aknepper/aknepper_clock/HPS_Round_Clock/HPS_Round_Clock.kicad_pcb

## KiCad design HPS_Round_Clock/HPS_Round_Clock.kicad_pcb (2022-07-21)

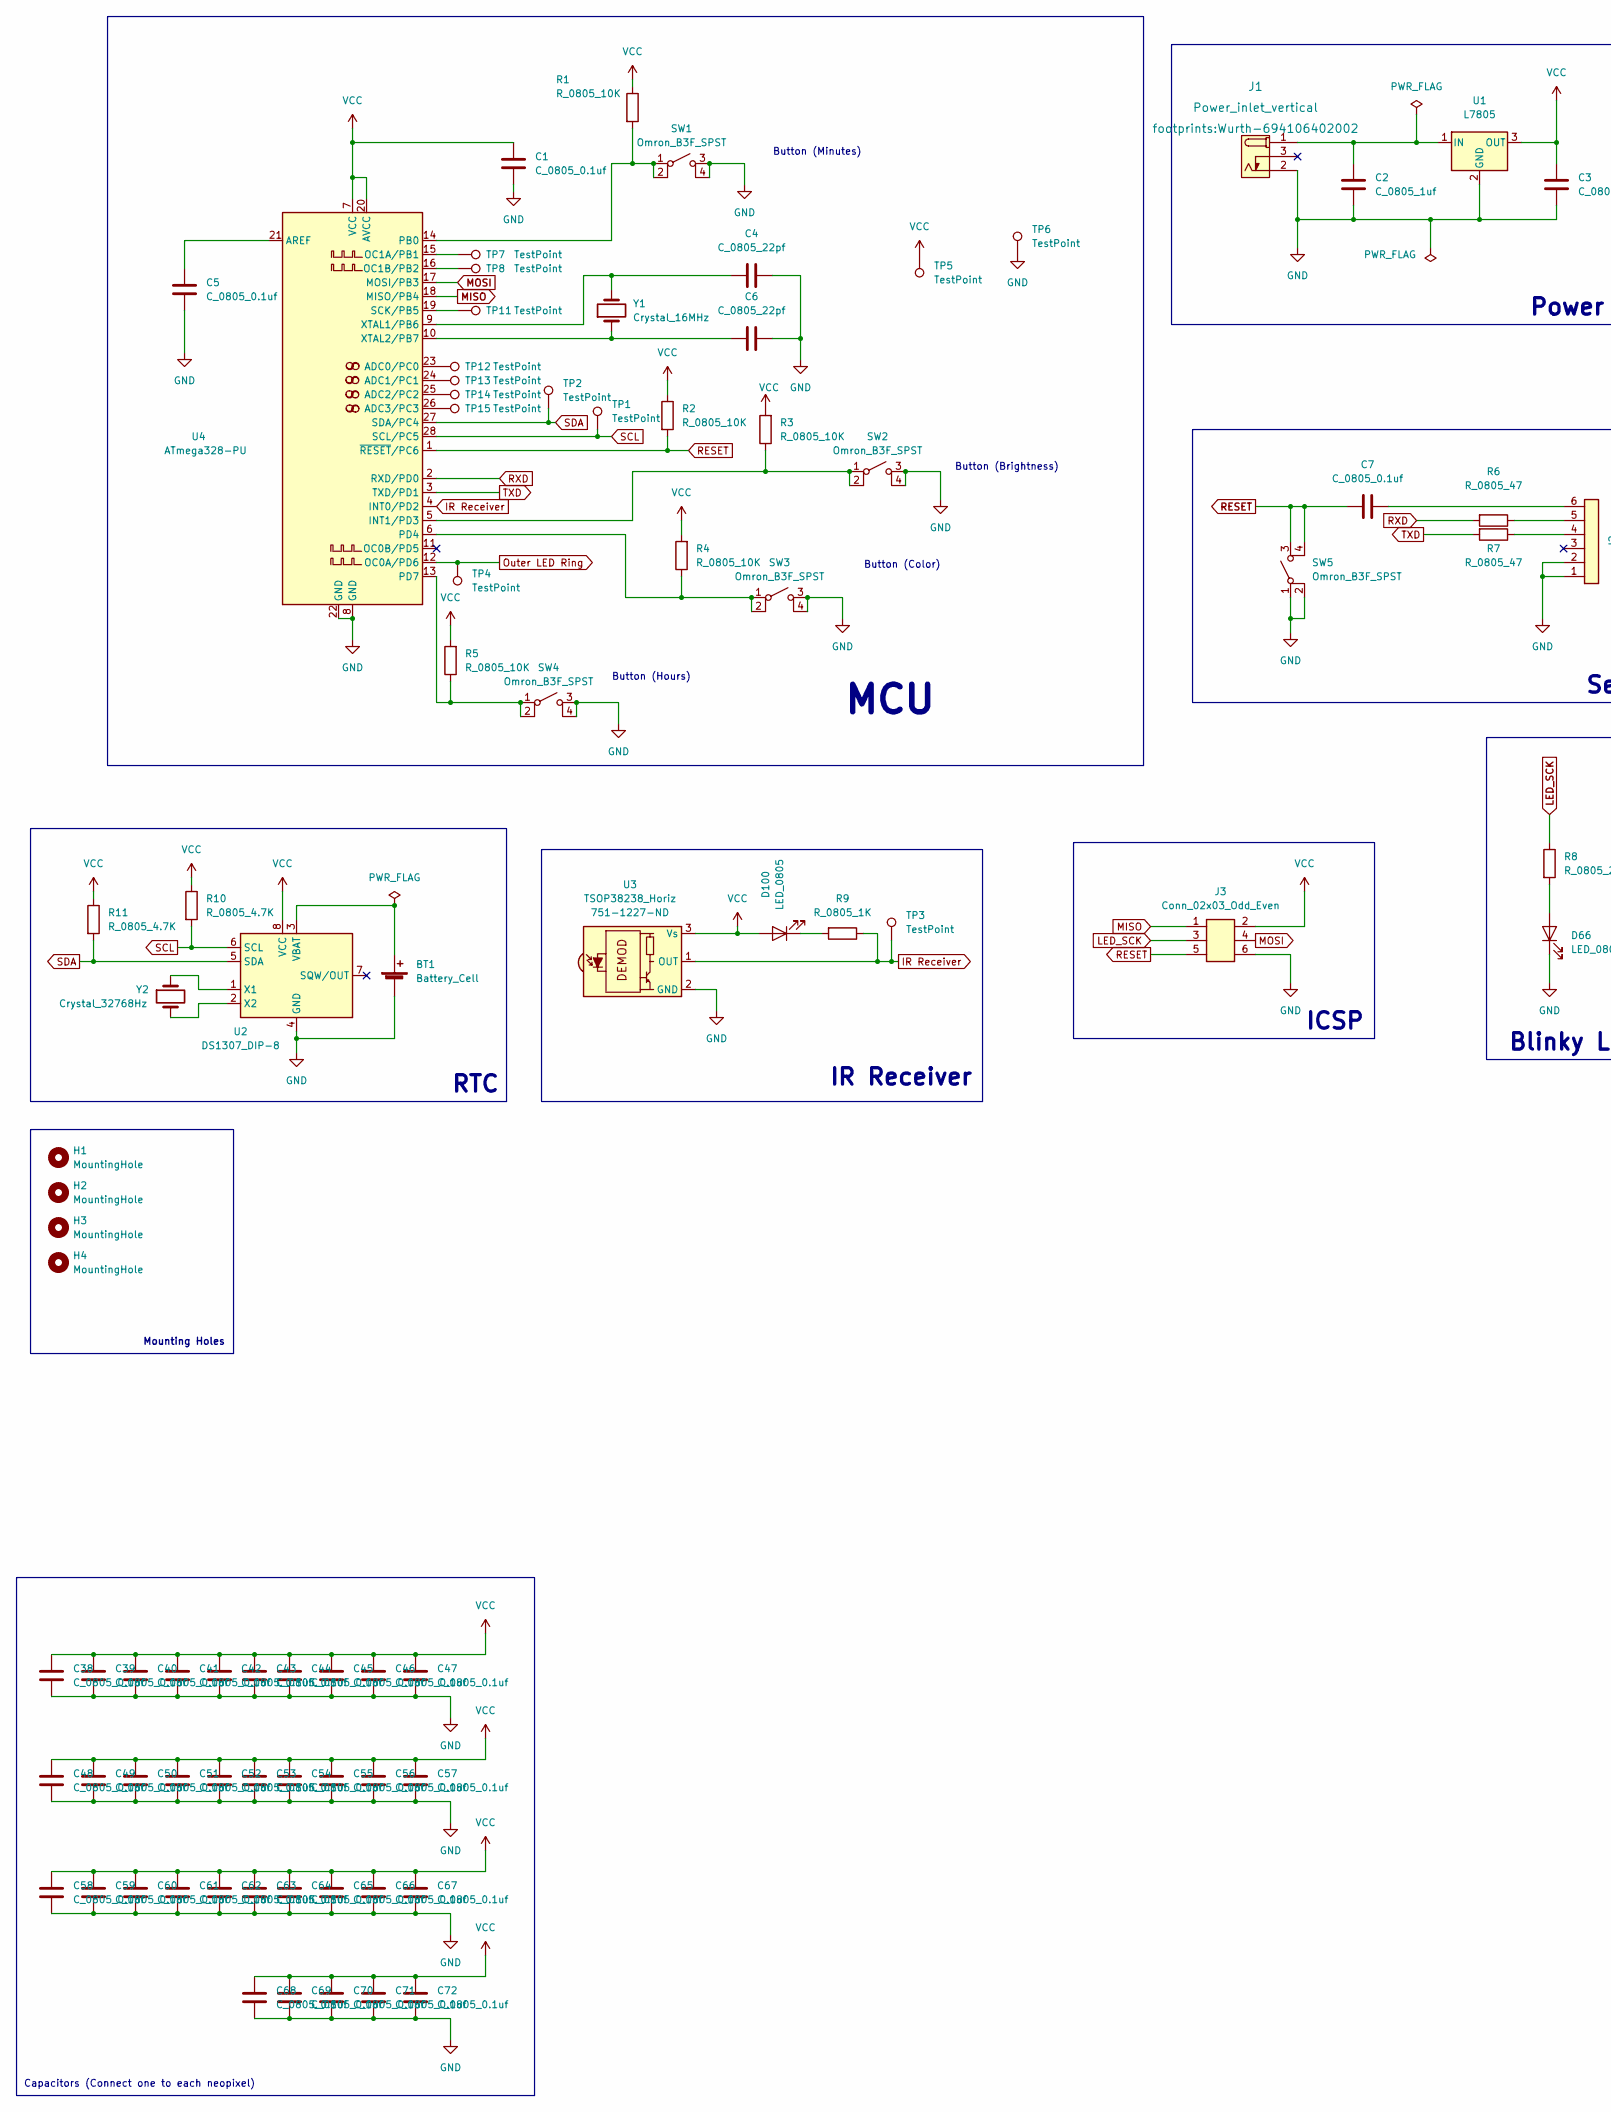
[picture p1: schematic HPS_Round_Clock.kicad_sch, part in row 1, column 1]

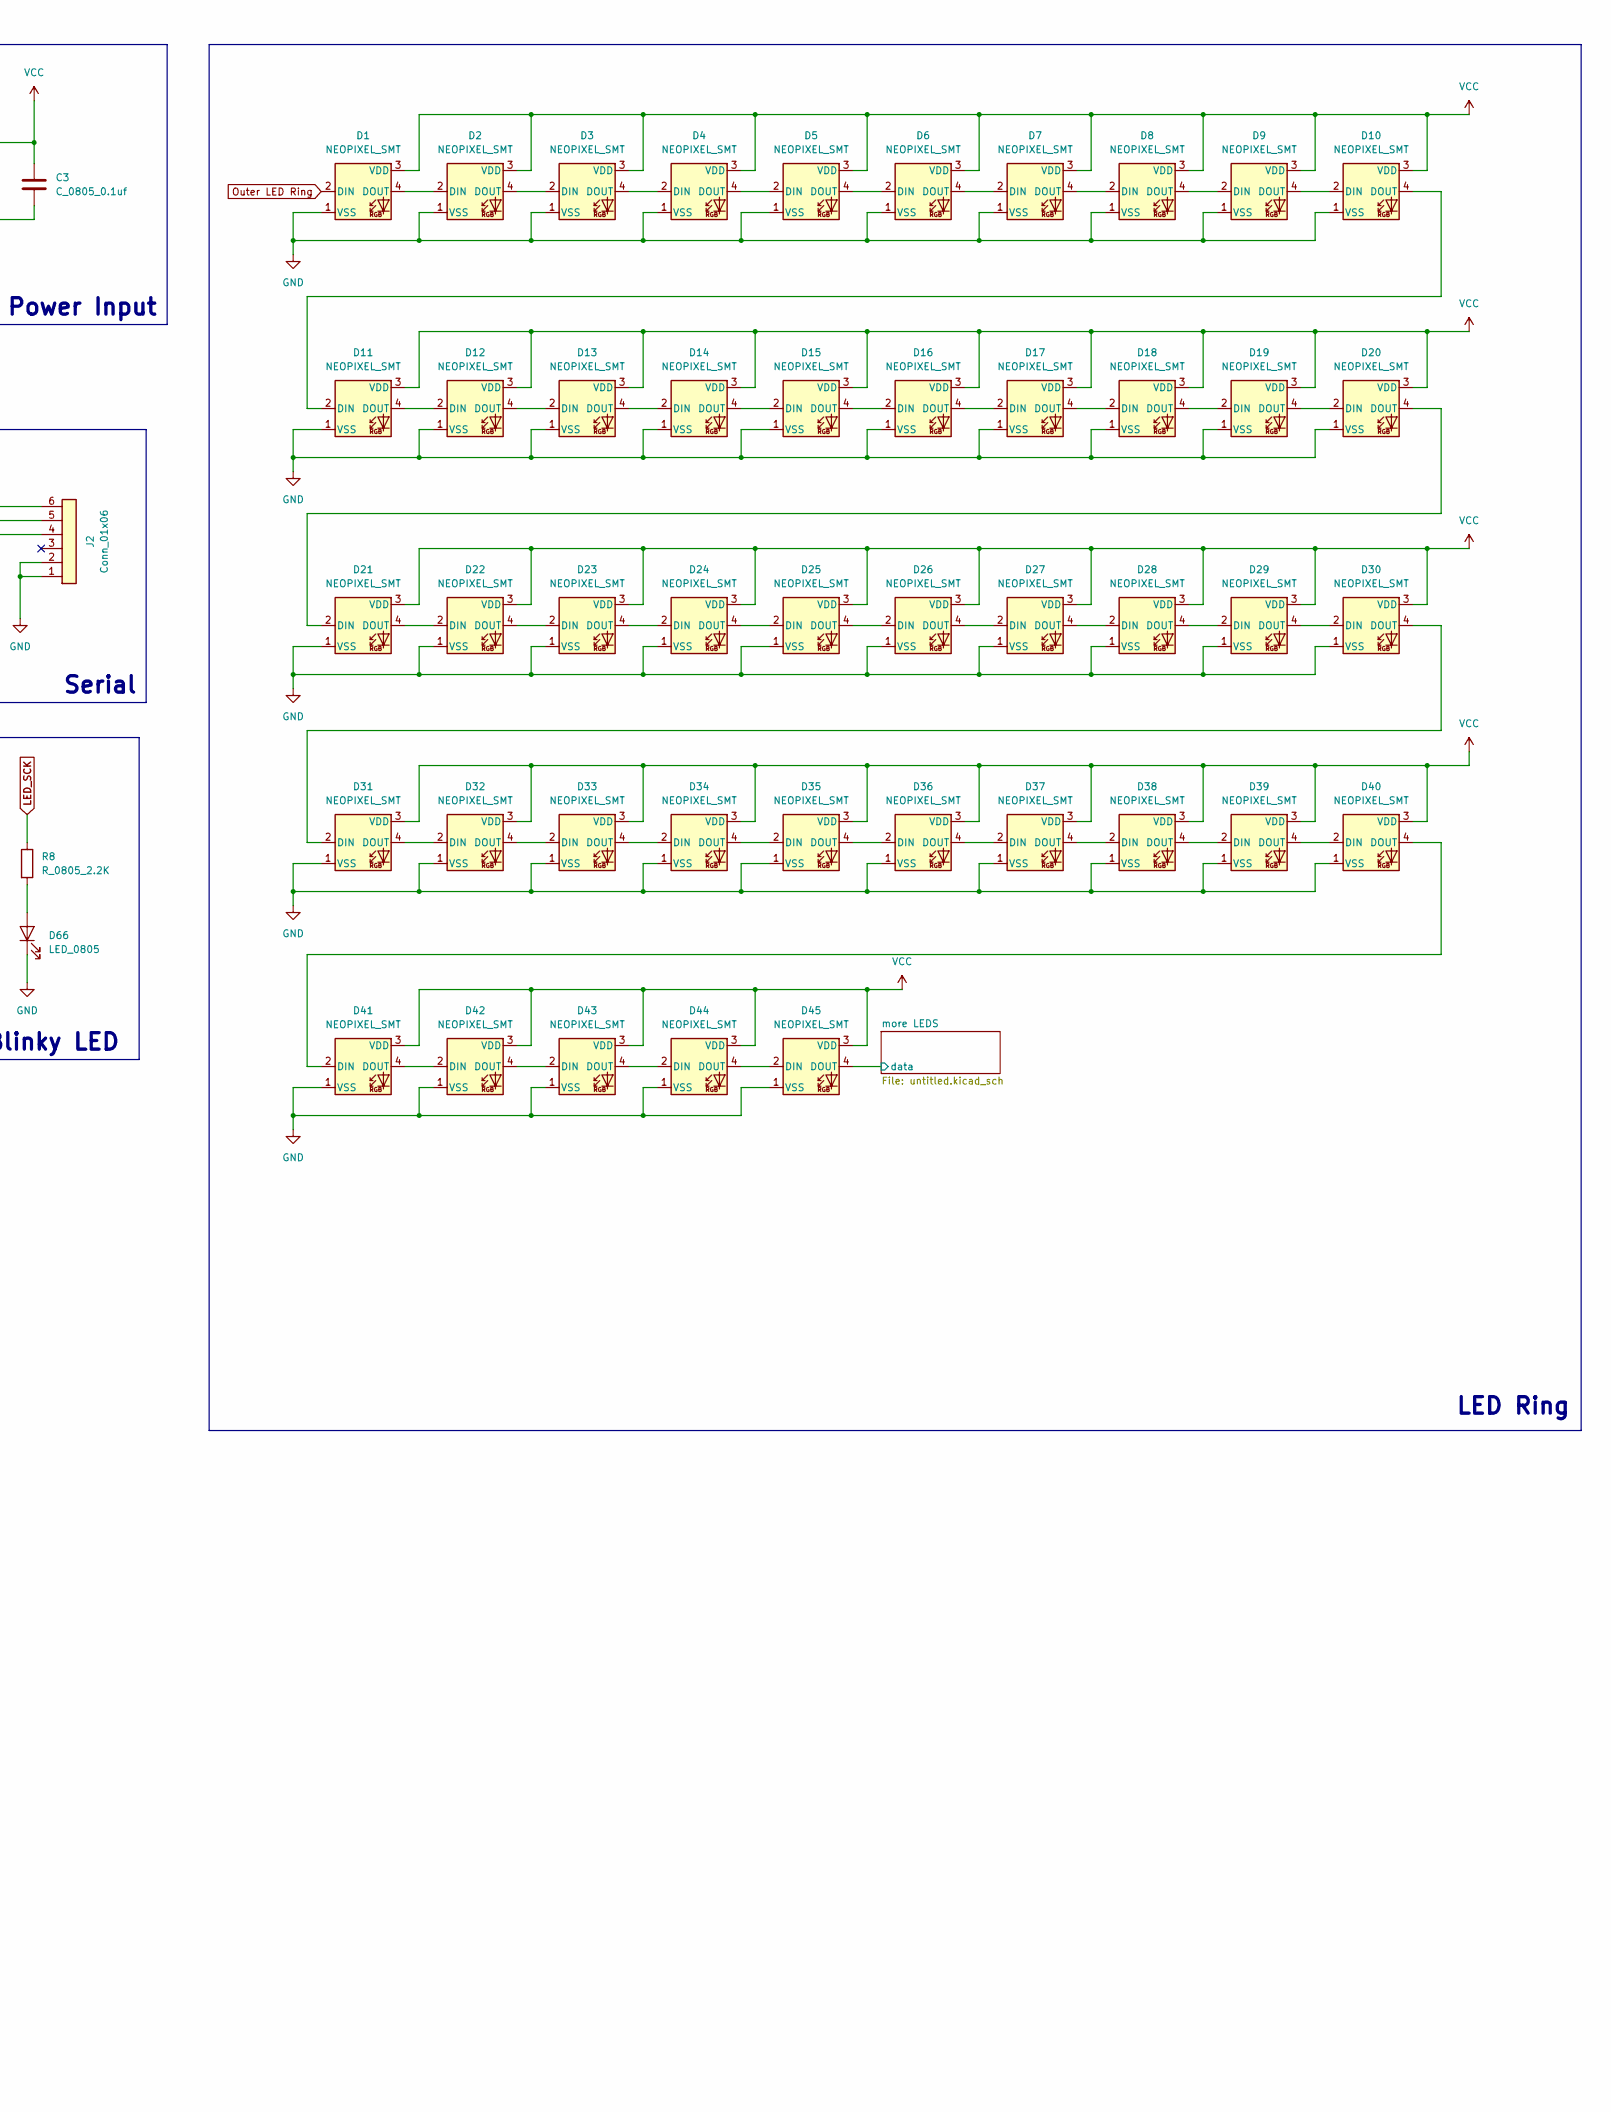
[picture p2: schematic HPS_Round_Clock.kicad_sch, part in row 1, column 2]

Parts:
BT1: Battery_Cell; BatteryHolder_Keystone_106_1x20mm; MPN BS-7; Digikey PN BS-7-ND
C1, C3, C5, C7, C38, C39, C40, C41, C42, C43, C44, C45, C46, C47, C48, C49, C50, C51, C52, C53, C54, C55, C56, C57, C58, C59, C60, C61, C62, C63, C64, C65, C66, C67, C68, C69, C70, C71, C72: C_0805_0.1uf; C_0805_2012Metric; Voltage N/A; Tolerance N/A; MPN 08055C104KAT2A; Digikey PN 478-1395-1-ND
C2: C_0805_1uf; C_0805_2012Metric; Voltage N/A; Tolerance N/A; MPN CC0805KKX7R8BB105; Digikey PN 311-1456-1-ND
C4, C6: C_0805_22pf; C_0805_2012Metric; Voltage N/A; Tolerance N/A; MPN CC0805JRNPO9BN220; Digikey PN 311-1103-1-ND
D1, D2, D3, D4, D5, D6, D7, D8, D9, D10, D11, D12, D13, D14, D15, D16, D17, D18, D19, D20, D21, D22, D23, D24, D25, D26, D27, D28, D29, D30, D31, D32, D33, D34, D35, D36, D37, D38, D39, D40, D41, D42, D43, D44, D45: NEOPIXEL_SMT; LED_SK6812_PLCC4_5.0x5.0mm_P3.2mm; MPN IN-PI554FCH; Digikey PN 1830-1106-1-ND
D66, D100: LED_0805; LED_0805_2012Metric; MPN 150080RS75000; Digikey PN 732-4984-1-ND
H1, H2, H3, H4: MountingHole; MountingHole_3.2mm_M3
J1: Power_inlet_vertical; Wurth-694106402002; MPN 694106402002; Digikey PN 732-5931-ND
J2: Conn_01x06; PinHeader_1x06_P2.54mm_Vertical; MPN 61300611121; Digikey PN 732-5319-ND
J3: Conn_02x03_Odd_Even; PinHeader_2x03_P2.54mm_Vertical; MPN PRPC003DAAN-RC; Digikey PN S2011EC-03-ND
R1, R2, R3, R4, R5: R_0805_10K; R_0805_2012Metric; Tolerance N/A; MPN RC0805FR-0710KL; Digikey PN 311-10.0KCRCT-ND
R6, R7: R_0805_47; R_0805_2012Metric; Tolerance N/A; Mouser PN N/A; Digikey PN RC0805FR-0747RL
R8: R_0805_2.2K; R_0805_2012Metric; Tolerance N/A; MPN N/A; Digikey PN 311-2.20KCRCT-ND
R9: R_0805_1K; R_0805_2012Metric; Tolerance N/A; Mouser PN N/A; Digikey PN RC0805FR-0710KL
R10, R11: R_0805_4.7K; R_0805_2012Metric; Tolerance N/A; MPN RC0805FR-074K7L; Digikey PN 311-4.70KCRCT-ND
SW1, SW2, SW3, SW4, SW5: Omron_B3F_SPST; SW_SPST_Omron_B3FS-100xP; MPN B3FS-1000P; Digikey PN SW423CT-ND
TP1, TP2, TP3, TP4, TP5, TP6, TP7, TP8, TP11, TP12, TP13, TP14, TP15: TestPoint; TestPoint_THTPad_D2.0mm_Drill1.0mm
U1: L7805; TO-252-2; MPN L7805CDT-TR; Digikey PN 497-7255-1-ND
U2: DS1307_DIP-8; DIP-8_W7.62mm; MPN A 08-LC-TT; Digikey PN AE9986-ND
U3: TSOP38238_Horiz; Vishay_MINICAST-3Pin_Horiz; Digikey PN 751-1227-ND
U4: ATmega328-PU; DIP-28_W7.62mm; MPN ED281DT; Digikey PN ED3050-5-ND
Y1: Crystal_16MHz; Crystal_SMD_HC49-SD; MPN ECS-160-20-5PXDN-TR; Digikey PN XC1299CT-ND
Y2: Crystal_32768Hz; Crystal_SMD_2Pin_3.2x1.5mm; MPN Q 0,032768-JTX310-12,5-20-T1-HMR-50K-LF; Digikey PN 1908-1314-1-ND

Connections:
/more LEDS/data: D45.4 (DOUT); also elsewhere on the board
GND: BT1.2 (-), C1.2, C2.2, C3.2, C4.1, C5.2, C6.1, C38.2, C39.2, C40.2, C41.2, C42.2, C43.2, C44.2, C45.2, C46.2, C47.2, C48.2, C49.2, C50.2, C51.2, C52.2, C53.2, C54.2, C55.2, C56.2, C57.2, C58.2, C59.2, C60.2, C61.2, C62.2, C63.2, C64.2, C65.2, C66.2, C67.2, C68.2, C69.2, C70.2, C71.2, C72.2, D1.1 (VSS), D2.1 (VSS), D3.1 (VSS), D4.1 (VSS), D5.1 (VSS), D6.1 (VSS), D7.1 (VSS), D8.1 (VSS), D9.1 (VSS), D10.1 (VSS), D11.1 (VSS), D12.1 (VSS), D13.1 (VSS), D14.1 (VSS), D15.1 (VSS), D16.1 (VSS), D17.1 (VSS), D18.1 (VSS), D19.1 (VSS), D20.1 (VSS), D21.1 (VSS), D22.1 (VSS), D23.1 (VSS), D24.1 (VSS), D25.1 (VSS), D26.1 (VSS), D27.1 (VSS), D28.1 (VSS), D29.1 (VSS), D30.1 (VSS), D31.1 (VSS), D32.1 (VSS), D33.1 (VSS), D34.1 (VSS), D35.1 (VSS), D36.1 (VSS), D37.1 (VSS), D38.1 (VSS), D39.1 (VSS), D40.1 (VSS), D41.1 (VSS), D42.1 (VSS), D43.1 (VSS), D44.1 (VSS), D45.1 (VSS), D66.1 (K), J1.2 (OUT), J2.1, J2.2, J3.6, SW1.3 (B), SW1.4 (B), SW2.3 (B), SW2.4 (B), SW3.3 (B), SW3.4 (B), SW4.3 (B), SW4.4 (B), SW5.1 (A), SW5.2 (A), TP6.1, U1.2 (GND), U2.4 (GND), U3.2 (GND), U4.8 (GND), U4.22 (GND); also elsewhere on the board
IR Receiver: R9.1, TP3.1, U3.1 (OUT), U4.4 (INT0/PD2)
LED_SCK: J3.3, R8.1
MISO: J3.1, U4.18 (MISO/PB4)
MOSI: J3.4, U4.17 (MOSI/PB3)
unnamed: BT1.1 (+), U2.3 (VBAT)
unnamed: C2.1, J1.1 (POLE), U1.1 (IN)
unnamed: C4.2, U4.9 (XTAL1/PB6), Y1.2
unnamed: C5.1, U4.21 (AREF)
unnamed: C6.2, U4.10 (XTAL2/PB7), Y1.1
unnamed: C7.1, J2.6
unnamed: D1.4 (DOUT), D2.2 (DIN)
unnamed: D2.4 (DOUT), D3.2 (DIN)
unnamed: D3.4 (DOUT), D4.2 (DIN)
unnamed: D4.4 (DOUT), D5.2 (DIN)
unnamed: D5.4 (DOUT), D6.2 (DIN)
unnamed: D6.4 (DOUT), D7.2 (DIN)
unnamed: D7.4 (DOUT), D8.2 (DIN)
unnamed: D8.4 (DOUT), D9.2 (DIN)
unnamed: D9.4 (DOUT), D10.2 (DIN)
unnamed: D10.4 (DOUT), D11.2 (DIN)
unnamed: D11.4 (DOUT), D12.2 (DIN)
unnamed: D12.4 (DOUT), D13.2 (DIN)
unnamed: D13.4 (DOUT), D14.2 (DIN)
unnamed: D14.4 (DOUT), D15.2 (DIN)
unnamed: D15.4 (DOUT), D16.2 (DIN)
unnamed: D16.4 (DOUT), D17.2 (DIN)
unnamed: D17.4 (DOUT), D18.2 (DIN)
unnamed: D18.4 (DOUT), D19.2 (DIN)
unnamed: D19.4 (DOUT), D20.2 (DIN)
unnamed: D20.4 (DOUT), D21.2 (DIN)
unnamed: D21.4 (DOUT), D22.2 (DIN)
unnamed: D22.4 (DOUT), D23.2 (DIN)
unnamed: D23.4 (DOUT), D24.2 (DIN)
unnamed: D24.4 (DOUT), D25.2 (DIN)
unnamed: D25.4 (DOUT), D26.2 (DIN)
unnamed: D26.4 (DOUT), D27.2 (DIN)
unnamed: D27.4 (DOUT), D28.2 (DIN)
unnamed: D28.4 (DOUT), D29.2 (DIN)
unnamed: D29.4 (DOUT), D30.2 (DIN)
unnamed: D30.4 (DOUT), D31.2 (DIN)
unnamed: D31.4 (DOUT), D32.2 (DIN)
unnamed: D32.4 (DOUT), D33.2 (DIN)
unnamed: D33.4 (DOUT), D34.2 (DIN)
unnamed: D34.4 (DOUT), D35.2 (DIN)
unnamed: D35.4 (DOUT), D36.2 (DIN)
unnamed: D36.4 (DOUT), D37.2 (DIN)
unnamed: D37.4 (DOUT), D38.2 (DIN)
unnamed: D38.4 (DOUT), D39.2 (DIN)
unnamed: D39.4 (DOUT), D40.2 (DIN)
unnamed: D40.4 (DOUT), D41.2 (DIN)
unnamed: D41.4 (DOUT), D42.2 (DIN)
unnamed: D42.4 (DOUT), D43.2 (DIN)
unnamed: D43.4 (DOUT), D44.2 (DIN)
unnamed: D44.4 (DOUT), D45.2 (DIN)
unnamed: D66.2 (A), R8.2
unnamed: D100.1 (K), R9.2
unnamed: J2.4, R7.1
unnamed: J2.5, R6.1
unnamed: R1.2, SW1.1 (A), SW1.2 (A), U4.14 (PB0)
unnamed: R3.1, SW2.1 (A), SW2.2 (A), U4.5 (INT1/PD3)
unnamed: R4.1, SW3.1 (A), SW3.2 (A), U4.6 (PD4)
unnamed: R5.1, SW4.1 (A), SW4.2 (A), U4.13 (PD7)
unnamed: TP7.1, U4.15 (OC1A/PB1)
unnamed: TP8.1, U4.16 (OC1B/PB2)
unnamed: TP11.1, U4.19 (SCK/PB5)
unnamed: TP12.1, U4.23 (ADC0/PC0)
unnamed: TP13.1, U4.24 (ADC1/PC1)
unnamed: TP14.1, U4.25 (ADC2/PC2)
unnamed: TP15.1, U4.26 (ADC3/PC3)
unnamed: U2.1 (X1), Y2.1
unnamed: U2.2 (X2), Y2.2
Outer LED Ring: D1.2 (DIN), TP4.1, U4.12 (OC0A/PD6)
RESET: C7.2, J3.5, R2.2, SW5.3 (B), SW5.4 (B), U4.1 (~RESET/PC6)
RXD: R6.2, U4.2 (RXD/PD0)
SCL: R10.2, TP1.1, U2.6 (SCL), U4.28 (SCL/PC5)
SDA: R11.2, TP2.1, U2.5 (SDA), U4.27 (SDA/PC4)
TXD: R7.2, U4.3 (TXD/PD1)
VCC: C1.1, C3.1, C38.1, C39.1, C40.1, C41.1, C42.1, C43.1, C44.1, C45.1, C46.1, C47.1, C48.1, C49.1, C50.1, C51.1, C52.1, C53.1, C54.1, C55.1, C56.1, C57.1, C58.1, C59.1, C60.1, C61.1, C62.1, C63.1, C64.1, C65.1, C66.1, C67.1, C68.1, C69.1, C70.1, C71.1, C72.1, D1.3 (VDD), D2.3 (VDD), D3.3 (VDD), D4.3 (VDD), D5.3 (VDD), D6.3 (VDD), D7.3 (VDD), D8.3 (VDD), D9.3 (VDD), D10.3 (VDD), D11.3 (VDD), D12.3 (VDD), D13.3 (VDD), D14.3 (VDD), D15.3 (VDD), D16.3 (VDD), D17.3 (VDD), D18.3 (VDD), D19.3 (VDD), D20.3 (VDD), D21.3 (VDD), D22.3 (VDD), D23.3 (VDD), D24.3 (VDD), D25.3 (VDD), D26.3 (VDD), D27.3 (VDD), D28.3 (VDD), D29.3 (VDD), D30.3 (VDD), D31.3 (VDD), D32.3 (VDD), D33.3 (VDD), D34.3 (VDD), D35.3 (VDD), D36.3 (VDD), D37.3 (VDD), D38.3 (VDD), D39.3 (VDD), D40.3 (VDD), D41.3 (VDD), D42.3 (VDD), D43.3 (VDD), D44.3 (VDD), D45.3 (VDD), D100.2 (A), J3.2, R1.1, R2.1, R3.2, R4.2, R5.2, R10.1, R11.1, TP5.1, U1.3 (OUT), U2.8 (VCC), U3.3 (Vs), U4.7 (VCC), U4.20 (AVCC); also elsewhere on the board

Notes on the sheet:
MCU
Mounting Holes
LED Ring
Serial
Power Input
Blinky LED
IR Receiver
ICSP
Capacitors (Connect one to each neopixel)
Button (Brightness)
RTC
Button (Hours)
Button (Minutes)
Button (Color)

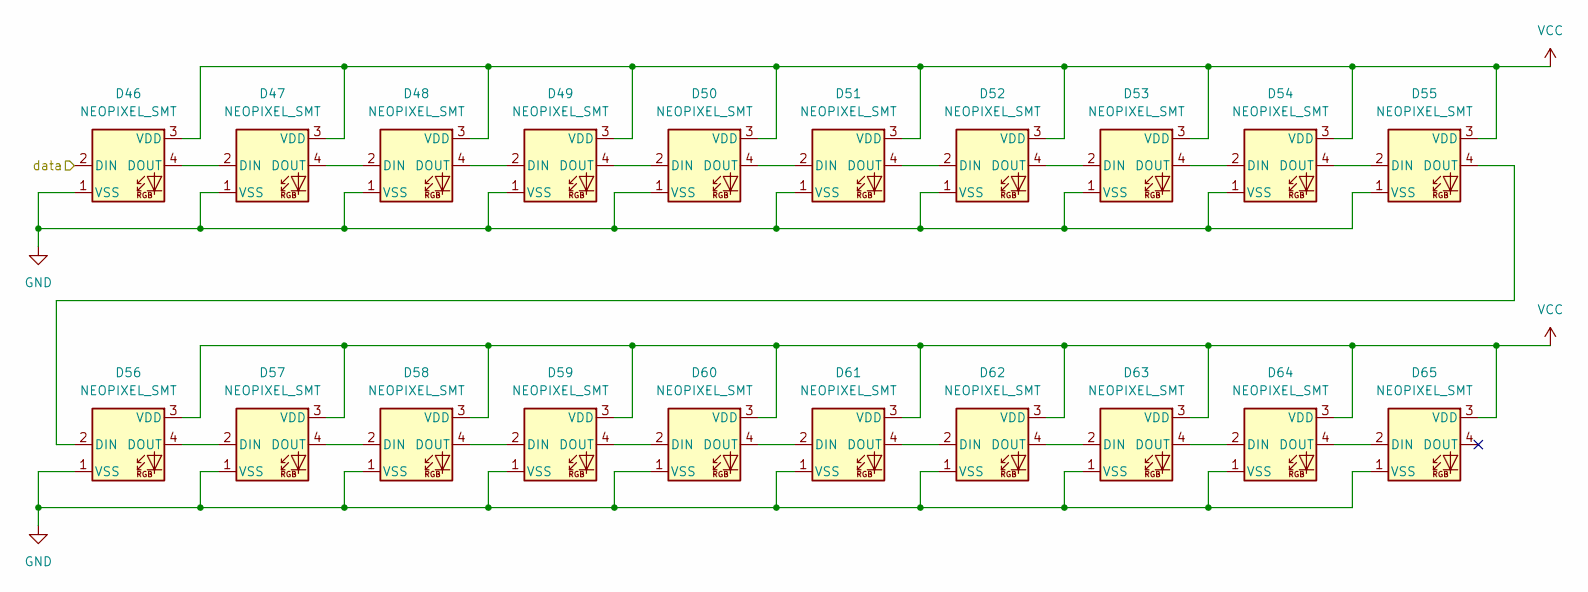
[picture p3: schematic untitled.kicad_sch]

Parts:
D46, D47, D48, D49, D50, D51, D52, D53, D54, D55, D56, D57, D58, D59, D60, D61, D62, D63, D64, D65: NEOPIXEL_SMT; LED_SK6812_PLCC4_5.0x5.0mm_P3.2mm; MPN IN-PI554FCH; Digikey PN 1830-1106-1-ND

Connections:
/more LEDS/data: D46.2 (DIN); also elsewhere on the board
GND: D46.1 (VSS), D47.1 (VSS), D48.1 (VSS), D49.1 (VSS), D50.1 (VSS), D51.1 (VSS), D52.1 (VSS), D53.1 (VSS), D54.1 (VSS), D55.1 (VSS), D56.1 (VSS), D57.1 (VSS), D58.1 (VSS), D59.1 (VSS), D60.1 (VSS), D61.1 (VSS), D62.1 (VSS), D63.1 (VSS), D64.1 (VSS), D65.1 (VSS); also elsewhere on the board
unnamed: D46.4 (DOUT), D47.2 (DIN)
unnamed: D47.4 (DOUT), D48.2 (DIN)
unnamed: D48.4 (DOUT), D49.2 (DIN)
unnamed: D49.4 (DOUT), D50.2 (DIN)
unnamed: D50.4 (DOUT), D51.2 (DIN)
unnamed: D51.4 (DOUT), D52.2 (DIN)
unnamed: D52.4 (DOUT), D53.2 (DIN)
unnamed: D53.4 (DOUT), D54.2 (DIN)
unnamed: D54.4 (DOUT), D55.2 (DIN)
unnamed: D55.4 (DOUT), D56.2 (DIN)
unnamed: D56.4 (DOUT), D57.2 (DIN)
unnamed: D57.4 (DOUT), D58.2 (DIN)
unnamed: D58.4 (DOUT), D59.2 (DIN)
unnamed: D59.4 (DOUT), D60.2 (DIN)
unnamed: D60.4 (DOUT), D61.2 (DIN)
unnamed: D61.4 (DOUT), D62.2 (DIN)
unnamed: D62.4 (DOUT), D63.2 (DIN)
unnamed: D63.4 (DOUT), D64.2 (DIN)
unnamed: D64.4 (DOUT), D65.2 (DIN)
VCC: D46.3 (VDD), D47.3 (VDD), D48.3 (VDD), D49.3 (VDD), D50.3 (VDD), D51.3 (VDD), D52.3 (VDD), D53.3 (VDD), D54.3 (VDD), D55.3 (VDD), D56.3 (VDD), D57.3 (VDD), D58.3 (VDD), D59.3 (VDD), D60.3 (VDD), D61.3 (VDD), D62.3 (VDD), D63.3 (VDD), D64.3 (VDD), D65.3 (VDD); also elsewhere on the board

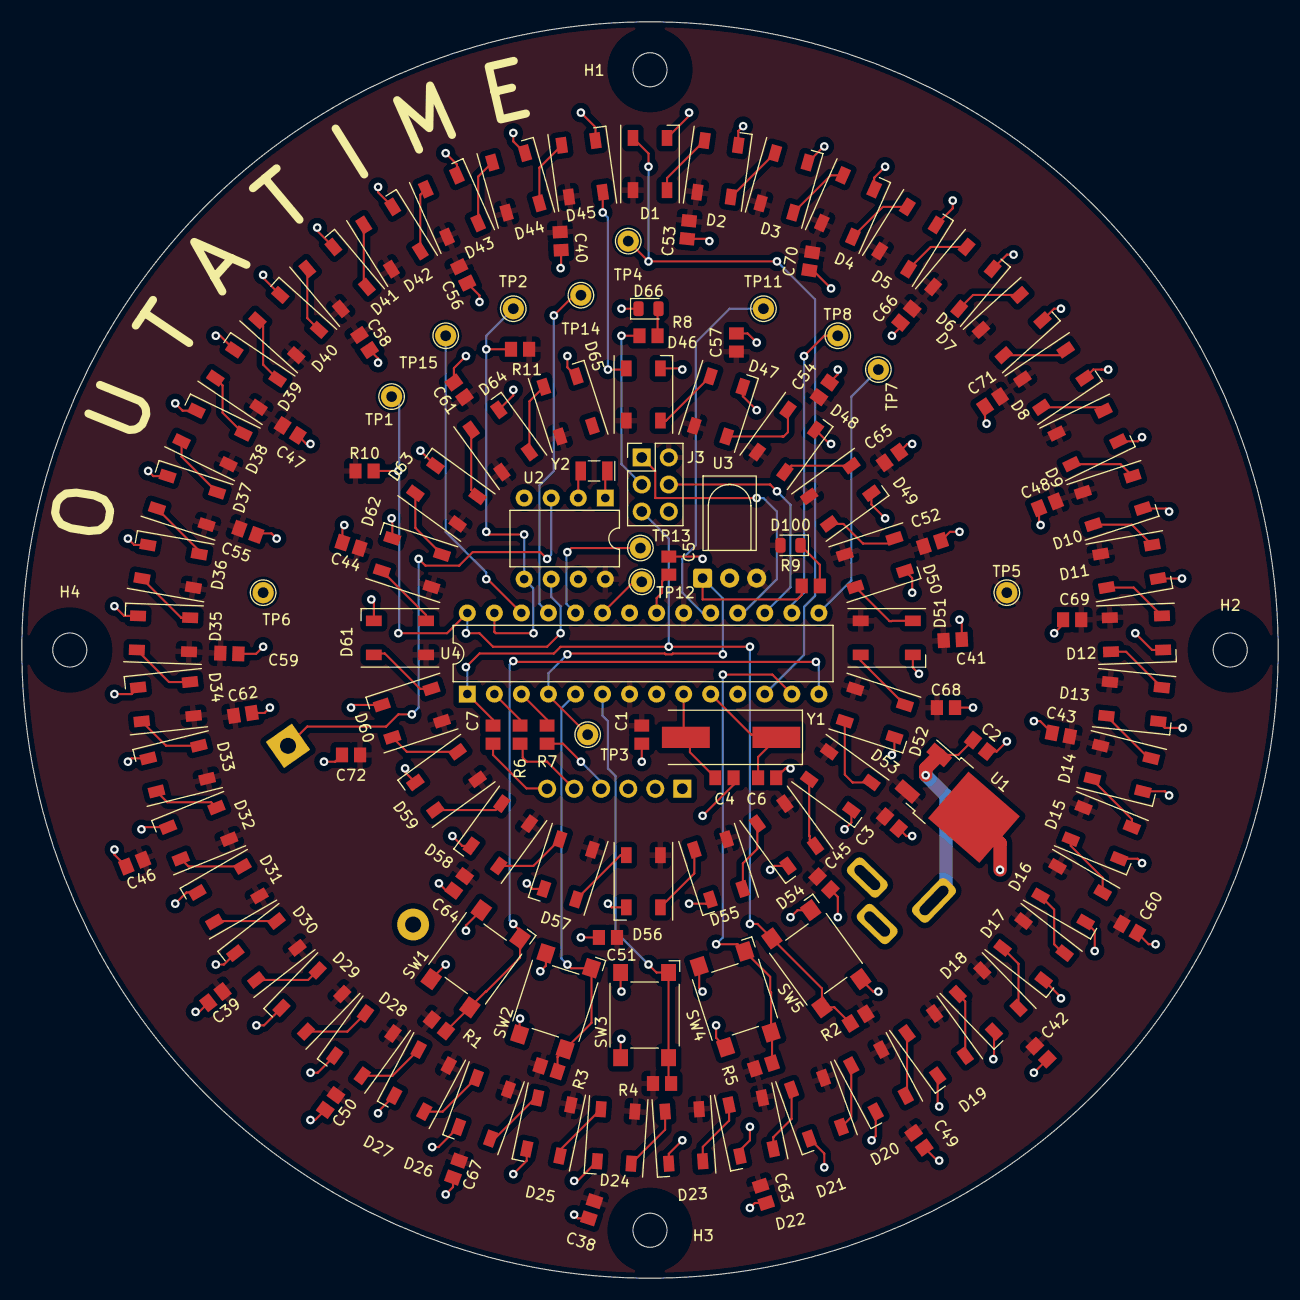
[picture p4: board HPS_Round_Clock.kicad_pcb from above]

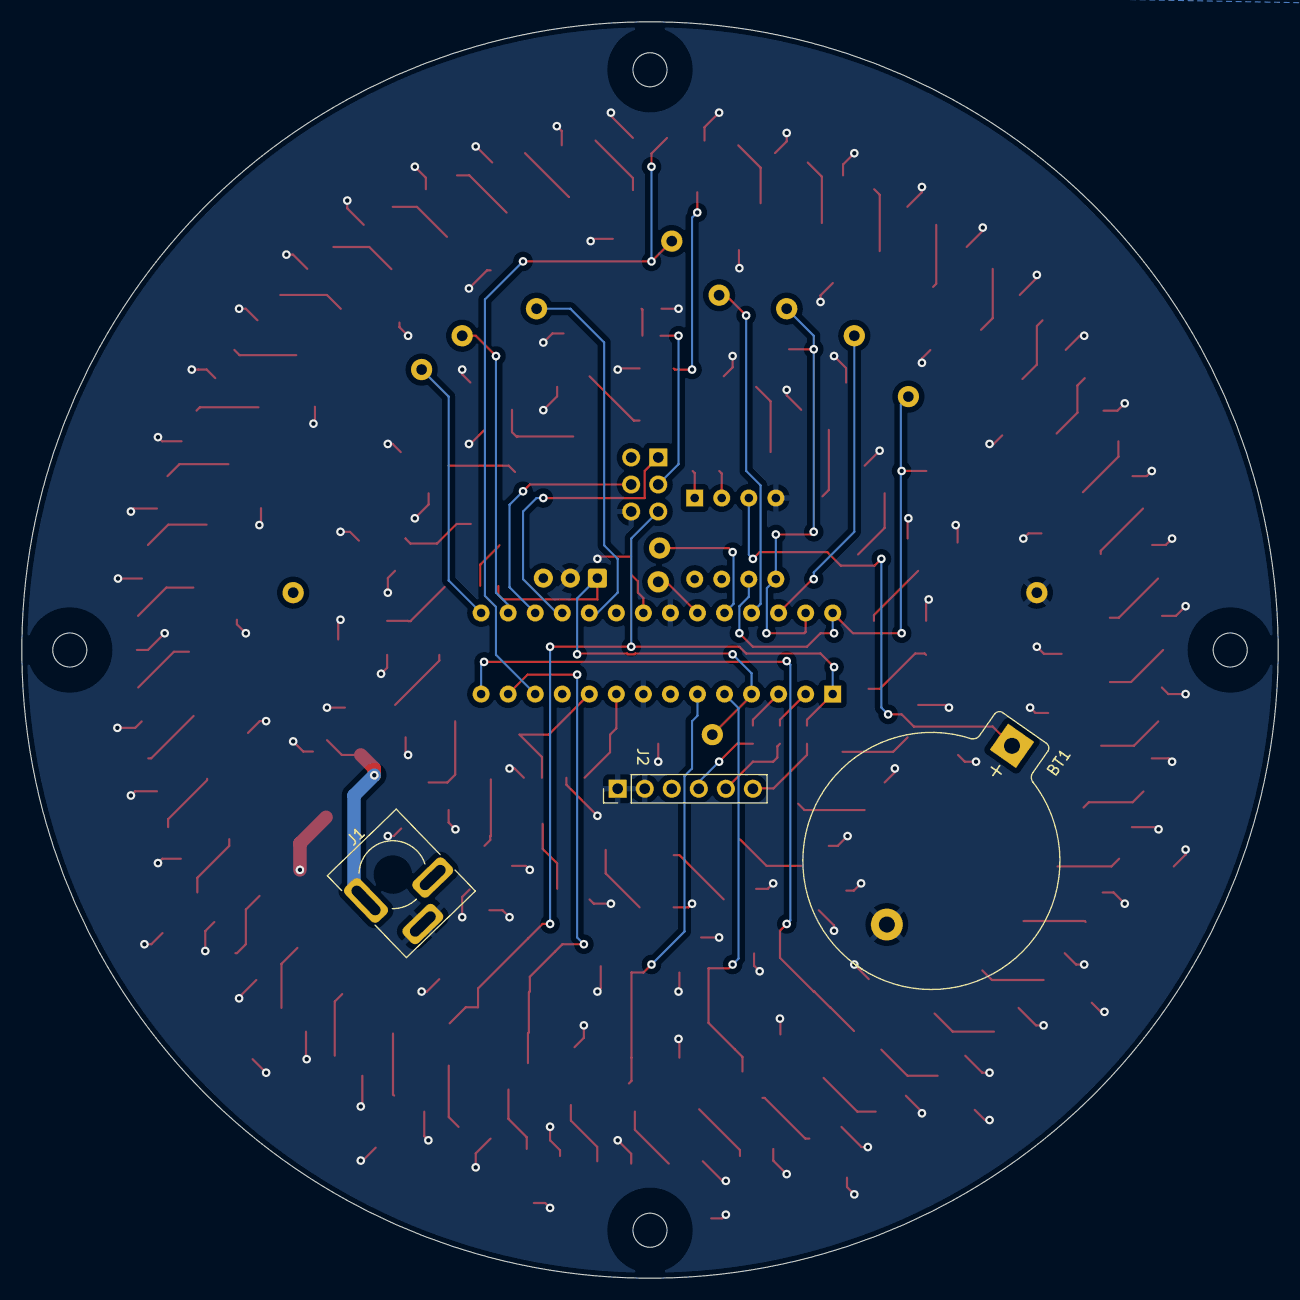
[picture p5: board HPS_Round_Clock.kicad_pcb from below]

Board: 2 copper layers, 118.0 x 118.0 mm, 152 parts (3 on the bottom side), 99 nets.
