aknepper/aknepper_clock/(commit log)

2022-06-05 Round Clock
    [HPS_Round_Clock.kicad_pcb, HPS_Round_Clock.kicad_sch]
2022-07-21 Full Gerber Push
    [HPS_Round_Clock-B_Cu.gbr, HPS_Round_Clock-B_Mask.gbr, HPS_Round_Clock-B_Paste.gbr, HPS_Round_Clock-B_Silkscreen.gbr, HPS_Round_Clock-Edge_Cuts.gbr, HPS_Round_Clock-F_Cu.gbr, HPS_Round_Clock-F_Mask.gbr, HPS_Round_Clock-F_Paste.gbr]
